synthetos/gQuintic-EEPROM-Header/README.md

# gQuintic-EEPROM-Header
An EEPROM board that plugs into the gQuintic SPI/I2C expansion header
