synthetos/gQuintic-EEPROM-Header/ProjectOutputs/EEPROM-I2C-Header-revB-schematics.pdf

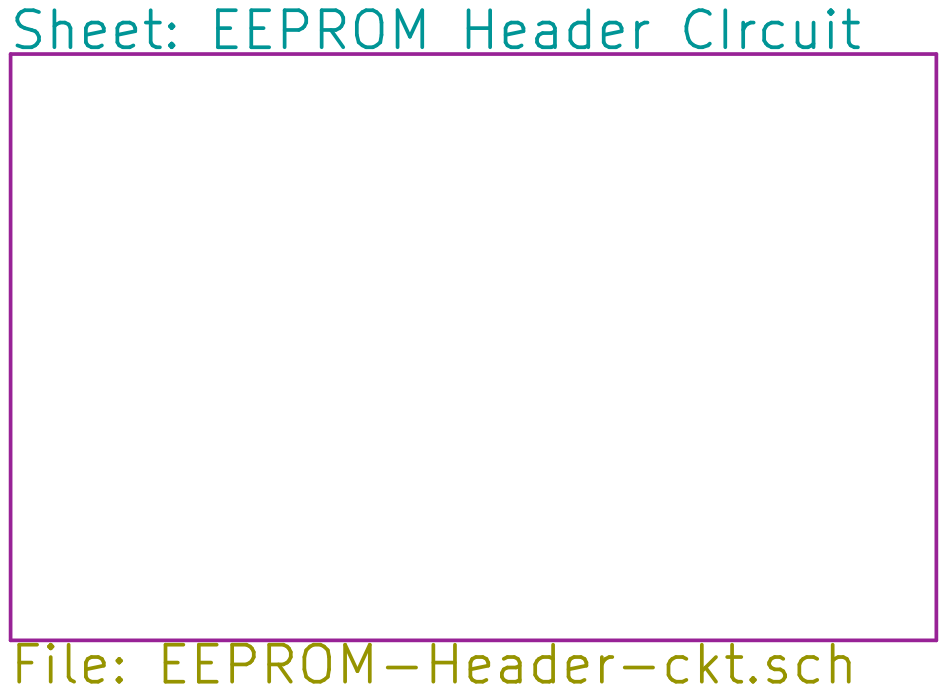
[picture p1: page 1]

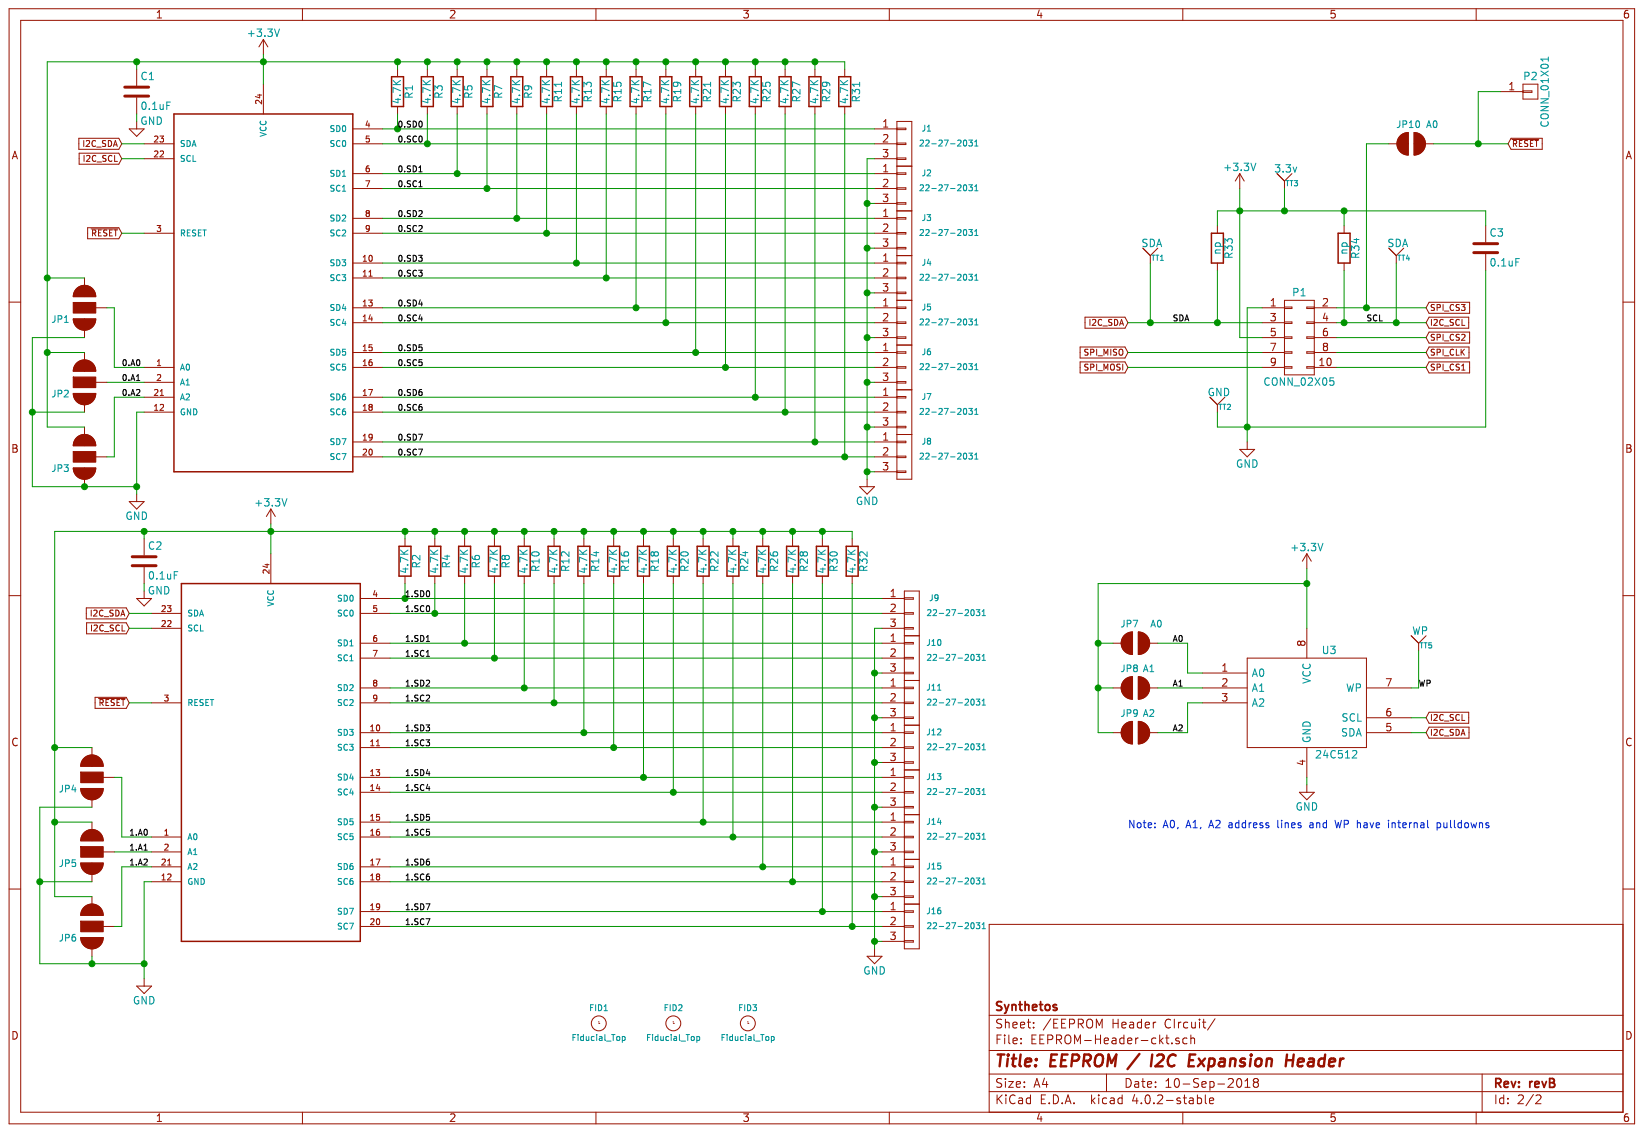
[picture p2: page 2]
