synthetos/gQuintic-EEPROM-Header/(commit log)

2018-07-02 Project setup commit
    [EEPROM-Header.kicad_pcb, EEPROM-Header.sch]
2018-07-02 First schematic
    [EEPROM-Header-ckt.sch, EEPROM-Header.sch]
2018-07-02 Checkpoint with two expansion headers
    [EEPROM-Header-ckt.sch, EEPROM-Header.kicad_pcb]
2018-07-02 Checkpoint, one header
    [EEPROM-Header-ckt.sch, EEPROM-Header.kicad_pcb]
2018-07-02 Updated PCB
    [EEPROM-Header-ckt.sch, EEPROM-Header.kicad_pcb]
2018-07-02 Final commit before generating outputs for fab
    [EEPROM-Header.kicad_pcb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]
2018-09-09 I2C mix - added 2 TCA9548 I2C expanders - Schematic only
    [EEPROM-Header-B.Cu.gbr, EEPROM-Header-B.Mask.gbr, EEPROM-Header-B.Paste.gbr, EEPROM-Header-Edge.Cuts.gbr, EEPROM-Header-F.Cu.gbr, EEPROM-Header-F.Mask.gbr, EEPROM-Header-F.Paste.gbr, EEPROM-Header-F.SilkS.gbr]
2018-09-09 Component placement on layout
    [EEPROM-Header-ckt.sch, EEPROM-Header.kicad_pcb]
2018-09-10 Better decoupling, added RESET point
    [EEPROM-Header-ckt.sch, EEPROM-Header.kicad_pcb]
2018-09-10 Semi-final revB before generating outputs
    [EEPROM-Header-ckt.sch, EEPROM-Header.kicad_pcb, EEPROM-Header.sch]
2018-09-10 Finalized and generated project outputs for fab
    [EEPROM-Header-B.Cu.gbr, EEPROM-Header-B.Mask.gbr, EEPROM-Header-B.Paste.gbr, EEPROM-Header-B.SilkS.gbr, EEPROM-Header-Edge.Cuts.gbr, EEPROM-Header-F.Cu.gbr, EEPROM-Header-F.Mask.gbr, EEPROM-Header-F.Paste.gbr]
